Schenktronics/ST01-multiple/docs/BOM.csv

Qty | Reference | Description | Manufacturer | Part Number | Link
8 | J1-J8 | 3.5mm mono switched jack, vertical, with nut (the oval pads also take panel-mount jacks such as CUI MJ-3507, with a wire from the sleeve lug to the square pad) | QingPu | WQP-PJ398SM or WQP518MA | http://www.qingpu-electronics.com/en/products/WQP-PJ398SM-362.html
1 | SW1 | Pushbutton switch, DPDT, latching (or equivalent with same pinout and plunger) | APEM | MHPS2285 | https://www.digikey.com/product-detail/en/apem-inc/MHPS2285/679-4053-ND/1795385
1 |  | Button cap, cylindrical, red, 6x5mm, fits MHPS2285 plunger | Tayda | A-5390 | https://www.taydaelectronics.com/push-button-switch-caps-red-color-6-x-5-mm-5390.html
1 |  | Main PCB, 15x100mm, 2-layer, 1.6mm | Schenktronics | ST-01 Multiple v1.1
1 |  | Faceplate, 3HP, 1.6mm aluminum PCB | Schenktronics | ST-01 Multiple Faceplate
