Schenktronics/ST01-multiple/hardware/jig/ST-01_Solder_Jig.stl

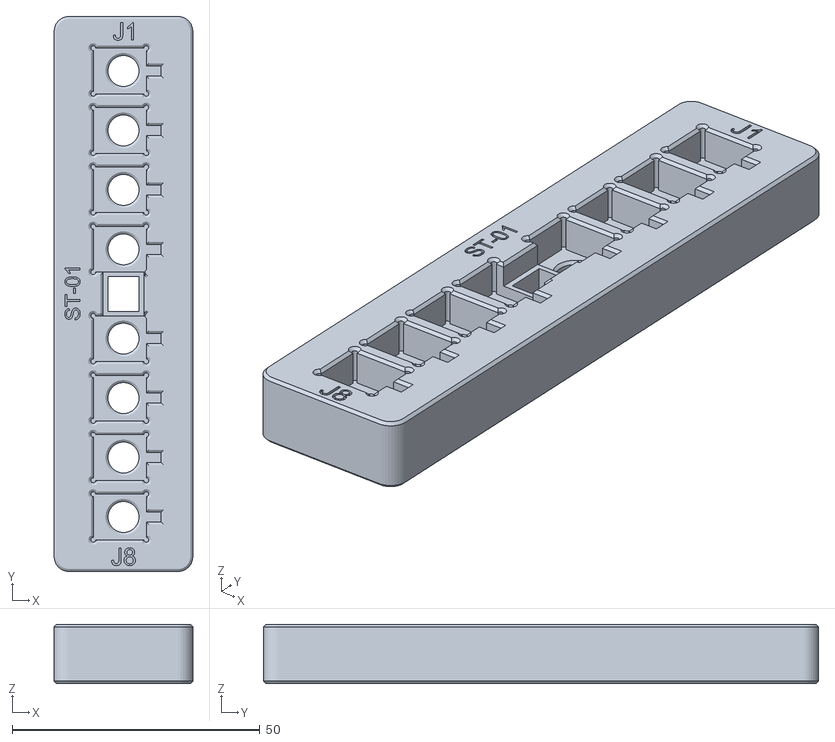
[picture p1: CAD file, 2026-10-28]
hardware/jig/ST-01_Solder_Jig.stl
28.0 x 112.0 x 12.0
