Schenktronics/ST01-multiple/(commit log)

2026-10-17 Regenerate the drawings for the v1.1 boards
    make_assembly_svgs.py still parsed the KiCad 5 file format, so it
    stopped working once the main PCB moved to KiCad 10, and the assembly
    drawings predated the jack-centering fix. It now reads the board with
    the same S-expression reader as the panel script, and skips the logo
    and license-badge footprints.
    The patch drawings were also stale: they were missing the ST-01 part
    number and logo added to the faceplate.
    Drawing titles use the "ST-01 Multiple: <view>" form, and captions and
    the drawings README use keyboard punctuation (straight quotes, no
    em-dashes, "6.0 mm" rather than a diameter sign).
2026-10-17 Polish the docs for launch: v1.1 boards, ST-01 naming, PDF names
    The boards being shipped are silkscreened "ST-01 v1.1", so the BOM,
    PDF covers, and the assembly guide's description of the back of the
    board now say v1.1 instead of v1.0.
    Titles and headings use "ST-01 Multiple" and body text uses "the
    Multiple", matching the panel and the shop. The PDFs are renamed to
    ST-01_Multiple_User_Manual.pdf and ST-01_Multiple_Assembly_Guide.pdf
    now, before launch, while nothing outside these repos links to them.
    The manual and assembly guide are reworded to read more naturally,
    with edits from Nathan: a short first-time soldering section, rubber
    bands to hold the faceplate, squaring up the jacks, an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
    [BOM.csv]
2026-10-17 Note the oval jack pads, use American spelling
    The jack footprint's oval pads let the board take panel-mount style
    jacks, which may be easier to source, so the README gains a "Sourcing
    your own parts" section and the BOM's jack row says so.
    Also: "aluminum" instead of "aluminium", a period instead of a
    semicolon in one image description and the drawings README, and the
    Oxford comma in the PDF README.
    [BOM.csv]
2026-10-17 Square up the jacks before soldering, snug the nuts last
    Nathan's refined build order: hand-tighten the jack nuts, square up the
    jack bodies with small pliers, center the parts, solder everything, and
    only then snug the nuts down. The faceplate drawing's caption now reads
    "..., solder, then tighten the nuts", and its nut label says
    "hand-tighten first".
2026-10-17 Add solder and lead-handling advice to the assembly guide
    The Tools list asks for 0.8 mm flux-core solder and safety glasses,
    without recommending leaded or lead-free, and the iron line notes that
    lead-free runs a little hotter. "First time soldering?" says 63/37 or
    60/40 leaded solder is easier to learn with and leaves the choice to
    the builder, with handling advice for leaded solder (wash hands, no
    eating, drinking, or smoking while soldering, wipe the work surface,
    keep it away from kids) and a separate note on ventilation and flux
    fumes.
2026-10-17 Explain the oval jack pads with the CUI MJ-3507, drop the Mouser project
    The jack pads are oval so the board also takes panel-mount style jacks.
    The README, the BOM's jack row, and a new "Using panel-mount style
    jacks?" note in the assembly guide now say so with one example, the
    CUI MJ-3507, whose sleeve is a solder lug that needs a short wire to
    the square pad. QingPu stays the main part in the BOM.
    The out-of-date Mouser project link and the BOM's "Ordering the
    parts" section are removed.
    [BOM.csv]
2026-10-24 Add a 3D-printable solder jig
    The jig holds the eight jacks and the button square and centred while
    they are soldered, in place of the faceplate, so all nine parts can be
    soldered in one go. Tested on an ST-01 build with 0.1 mm per-side
    pocket clearance. The README gives the print settings and the order
    of use: parts into the PCB, jig over them, flip, solder.
    [ST-01_Solder_Jig.stl]
2026-10-24 Assembly guide: building with the solder jig
    The guide still assumed the faceplate was the only way to align the
    jacks and center the button. It now lists the printed jig as an
    optional tool and gives the jig build: parts into the PCB, jig over
    them, flip, solder all 30 joints, then cap, faceplate and nuts, with
    Step 4 skipped. Also "centred" -> "centered" in the README to match
    the rest of the repo.
2026-10-26 Solder jig: use the measured jack height
    Exported from ST-01 Assembly Jig v5. The jacks measure 9.97 mm tall,
    not the 9.0 mm of the 3D model, so the switch pocket is shallower (its
    floor rose from 4.0 to 3.03 mm deep) to keep the switch flush on the
    board. The jig's outside size is unchanged. The board now stands about
    5 mm above the jig, so the README and assembly guide say so.
    [ST-01_Solder_Jig.stl]
2026-10-28 Solder jig: 4 mm board gap and chamfered pocket mouths
    Exported from ST-01 Assembly Jig v7. The jack pockets were a fixed
    5.0 mm deep, so with the measured 9.97 mm jacks the board stood about
    5 mm above the jig. They now follow the jack height (9.97 - 4 = 5.97 mm
    deep, the same as the ST-02 jig), so the board stands 4 mm above it, and
    the switch pocket floor moves with them (4.0 mm deep). The jig grows
    from 11 to 12 mm thick; its footprint is unchanged. Every pocket mouth
    gets a 0.5 mm lead-in chamfer so the loose-fitted parts find their
    pockets, as on the ST-02 jig. The README and assembly guide now say
    4 mm, and the README mentions the chamfers.
    [ST-01_Solder_Jig.stl]
